peterweissig/proj_audio_home/images/connection_external/1339.jpg

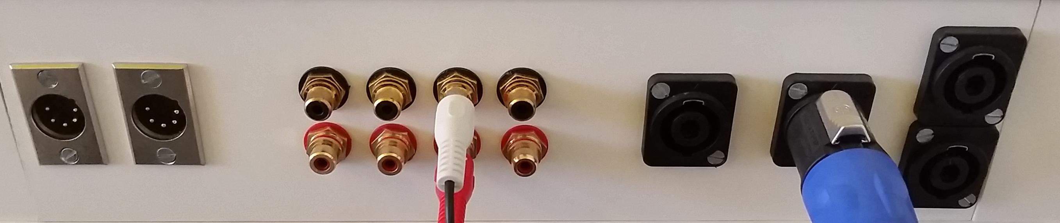
images/connection_external/1339.jpg
