peterweissig/proj_audio_home/README.md

# project_audio_home
Simple audio project for sound system @home
