peterweissig/proj_audio_home/circuits/amplifier/export/images/one_layer_pcb/circuit.png

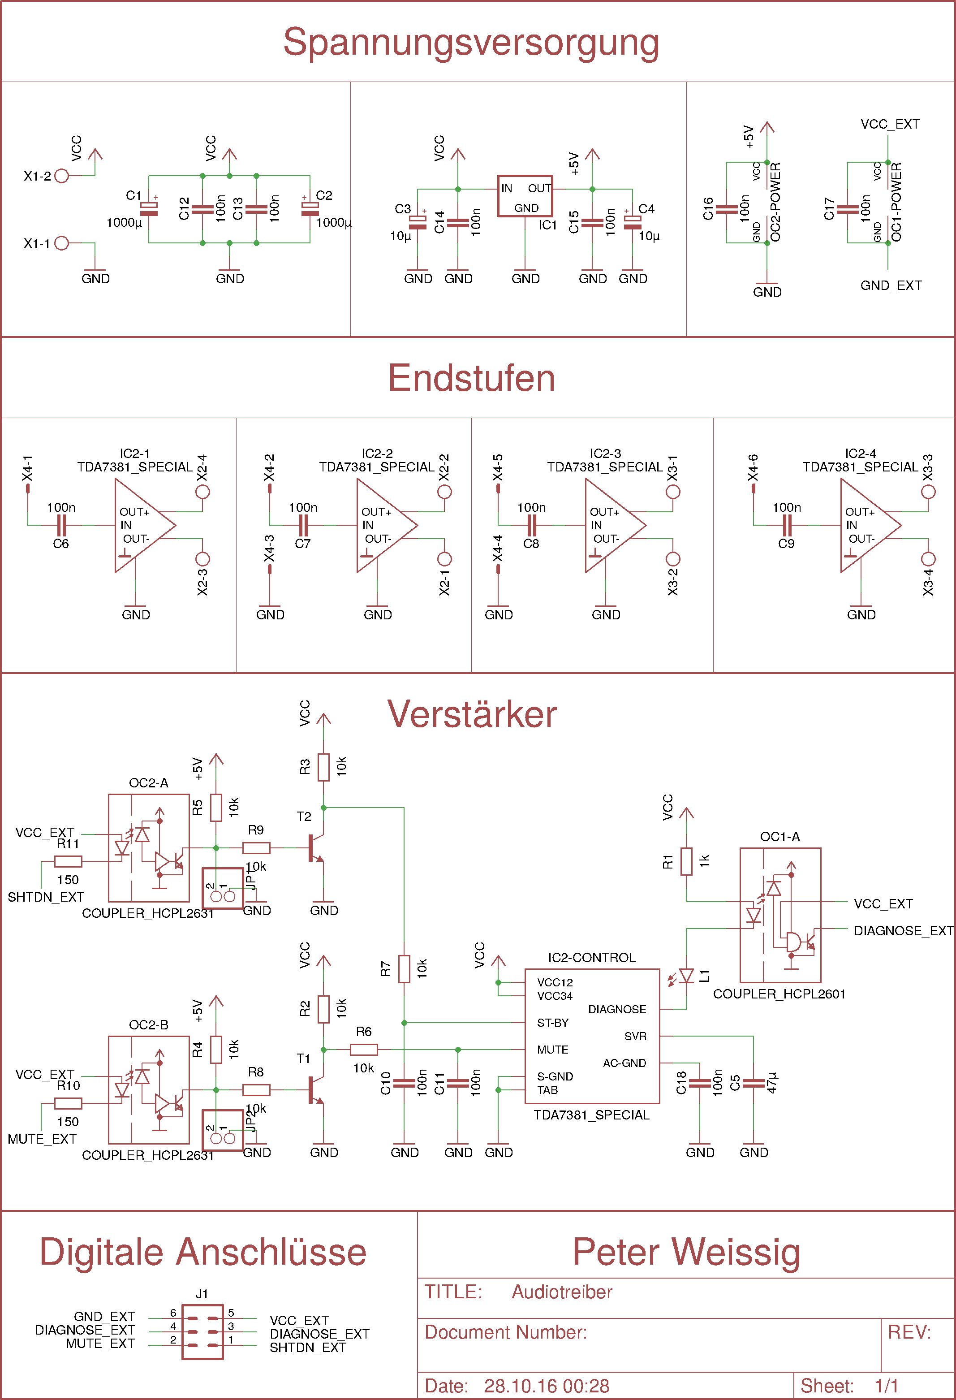
circuits/amplifier/export/images/one_layer_pcb/circuit.png
