peterweissig/proj_audio_home/circuits/amplifier/export/images/one_layer_pcb/layout.png

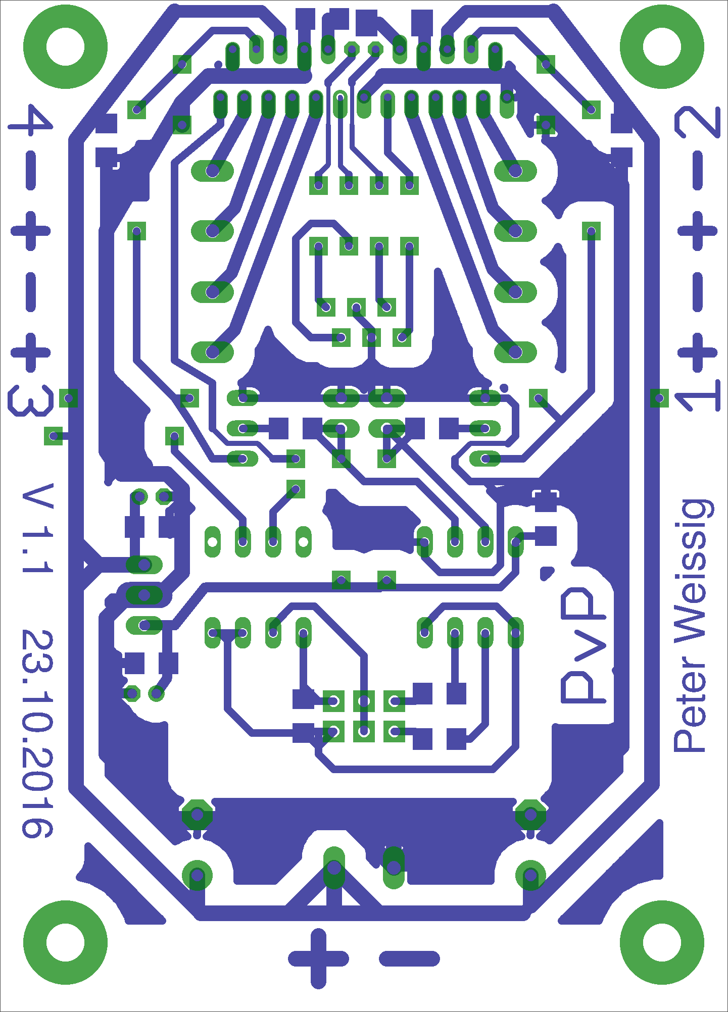
circuits/amplifier/export/images/one_layer_pcb/layout.png
