peterweissig/proj_audio_home/circuits/amplifier/two_layer_pcb/export/images/circuit.png

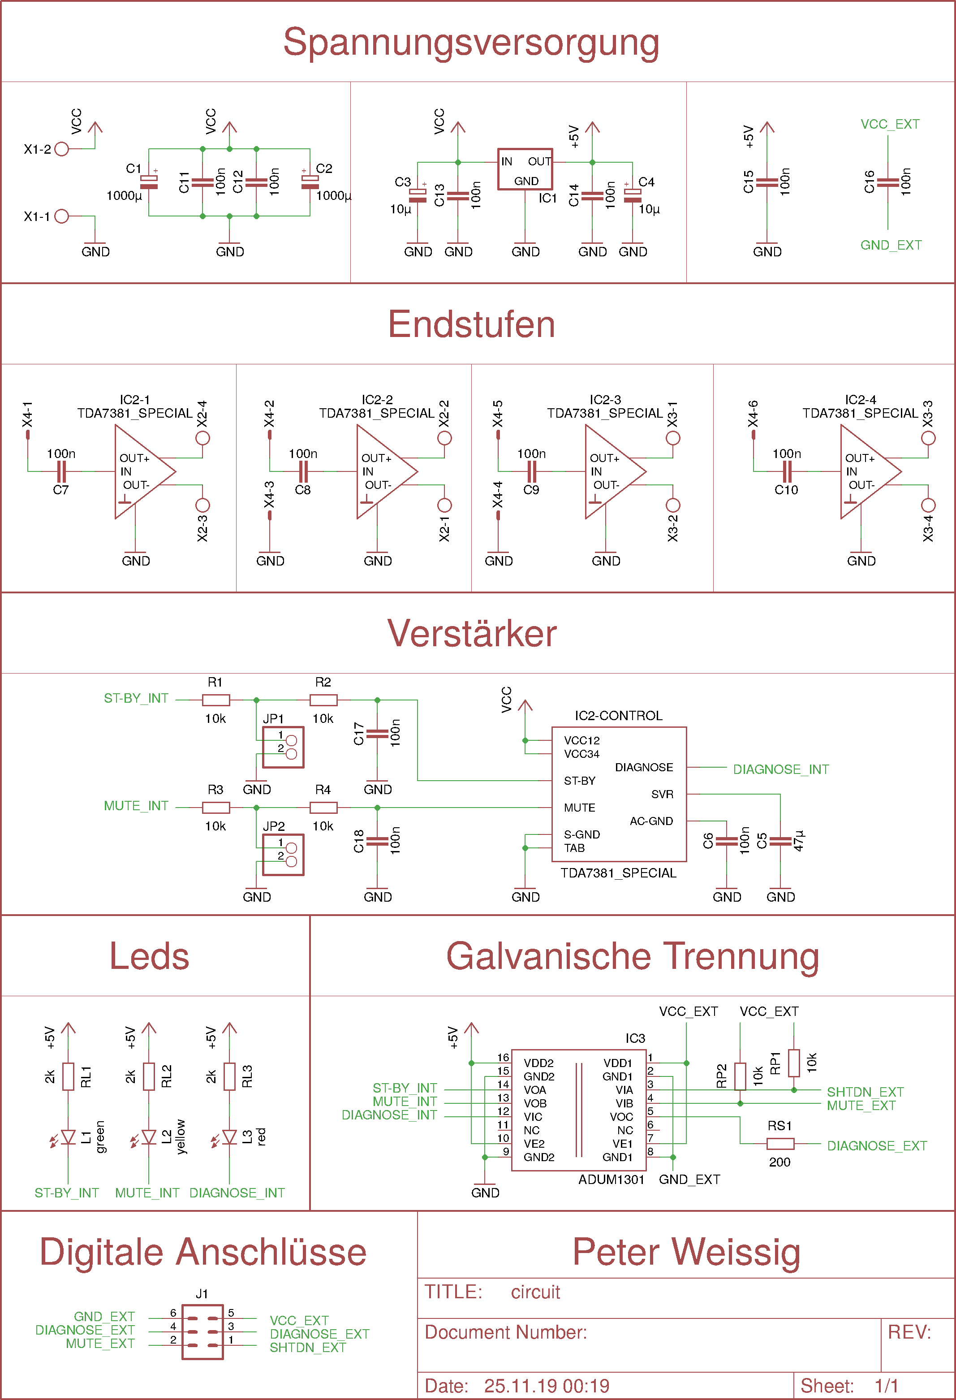
circuits/amplifier/two_layer_pcb/export/images/circuit.png
