peterweissig/proj_audio_home/drawings/connection_external/sketch.png

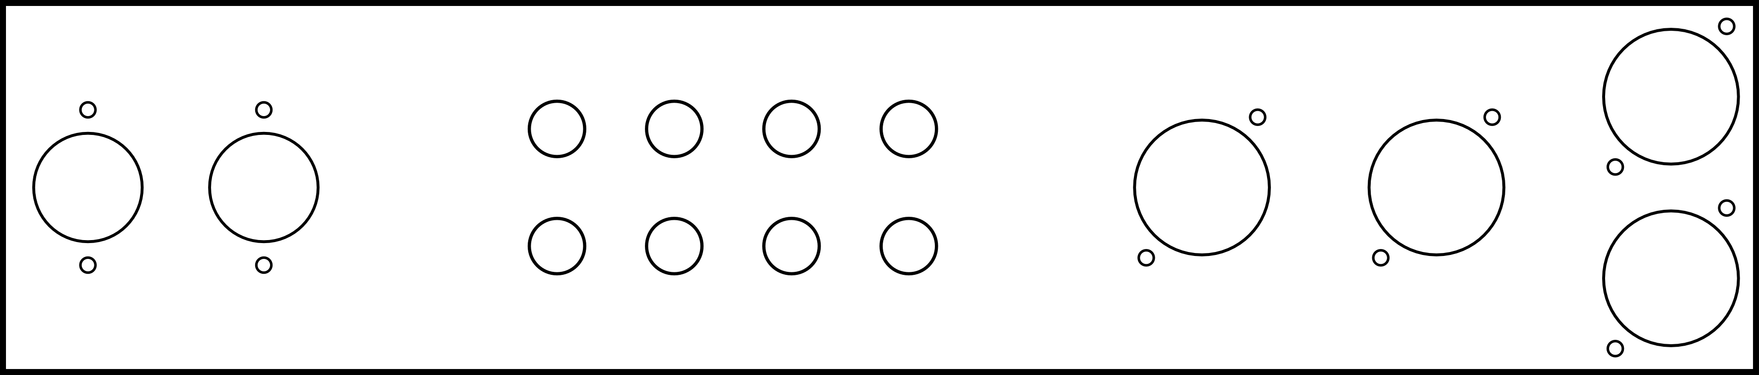
drawings/connection_external/sketch.png
