peterweissig/proj_audio_home/circuits/amplifier/parts/one_layer_pcb/parts.pdf

## Verstärker

Peter Weissig | Seite 1 von 1 | 28.10.2016
C1, C2 | 1000µF; d10; 5mm | RAD FR 1.000/25 | 2 | 0,29 € | 0,58 €
C3, C4 | 10µF; d5; 2,5mm | RAD FR 47/25 | 2 | 0,09 € | 0,18 €
C5 | 47µF; SMD 2312 | TAJ 6032 47/20 | 1 | 0,40 € | 0,40 €
C6, C7, C8, …, C11 | 100nF; 5mm | X7R-5 100N | 6 | 0,05 € | 0,30 €
C12, C13, …, C18 | 100nF; SMD 1206 | X7R-G1206 100N | 7 | 0,04 € | 0,28 €
IC1 | V-Reg; 5V; 1A | LM 2940 CT5 | 1 | 0,63 € | 0,63 €
IC2 | Audioverstärker; 4x; 100 | TDA 7381 | 1 | 3,20 € | 3,20 €
J1 | Wannenstecker 6-polig | | 1 | | 0,00 €
JP1, JP2 | Pinhead_1_2 | | 2 | | 0,00 €
L1 | Led_rot_3mm | | 1 | | 0,00 €
OC1 | Optokoppler; 1x | HCPL 2601 | 1 | 1,25 € | 1,25 €
OC2 | Optokoppler; 2x | HCPL 2631 | 1 | 1,80 € | 1,80 €
R1 | 1k; 10mm | | 1 | | 0,00 €
R2, R3, R4, …, R7 | 10k; 10mm | | 6 | | 0,00 €
R8, R9 | 10k; SMD 1206 | | 2 | | 0,00 €
R10, R11 | 150; SMD 1206 | | 2 | | 0,00 €
T1, T2 | BC548 | | 2 | | 0,00 €
X1 | Schraubanschluss; 2x | AKL 101-02 | 1 | 0,34 € | 0,34 €
X2, X3 | Schraubanschluss; 4x | RND 205-00014 | 2 | 0,25 € | 0,50 €
X4 | Micromatch 6-polig; BuchMM FL 6G | | 1 | 0,36 € | 0,36 €
IC_Sockel 8-polig | GS 8 | 2 | 0,04 € | 0,08 €
Micromatch 6-polig; SteckMM SL 6SK | | 1 | 0,26 € | 0,26 €
Kühlkörper | V 5583E | 1 | 2,30 € | 2,30 €
Sicherungsautomat; 4A | T9-611P 4A | 1 | 1,65 € | 1,65 €

14,11 €
‚
