peterweissig/proj_audio_home/circuits/amplifier/export/images/one_layer_pcb/parts_top.png

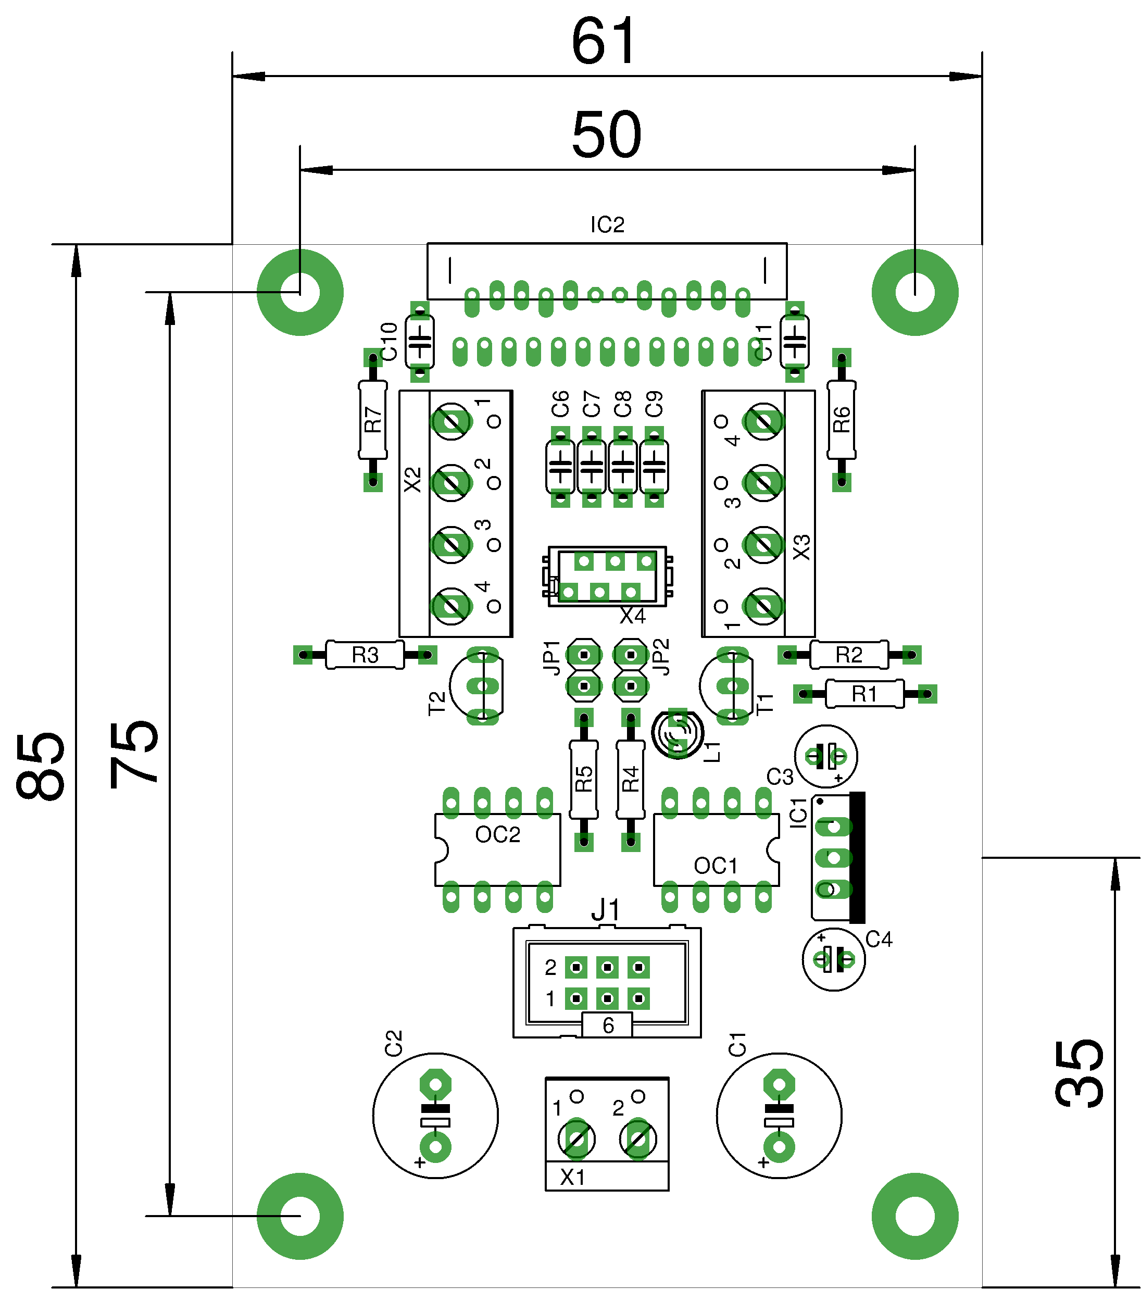
circuits/amplifier/export/images/one_layer_pcb/parts_top.png
