peterweissig/proj_audio_home/circuits/amplifier/two_layer_pcb/export/images/parts_bottom.png

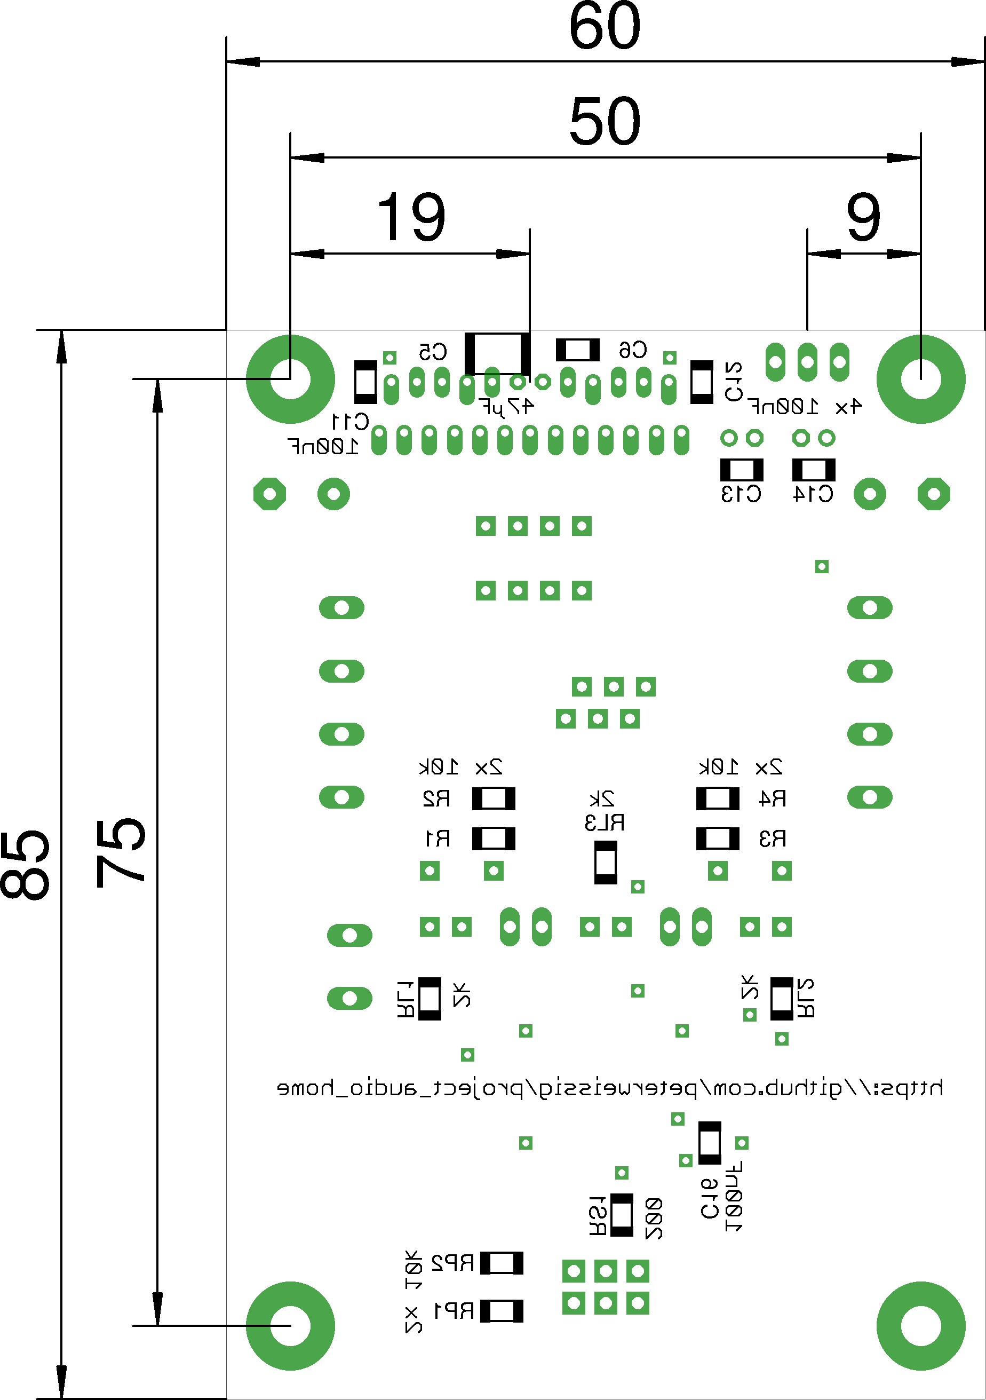
circuits/amplifier/two_layer_pcb/export/images/parts_bottom.png
