peterweissig/proj_audio_home/circuits/amplifier/two_layer_pcb/export/images/circuit.pdf

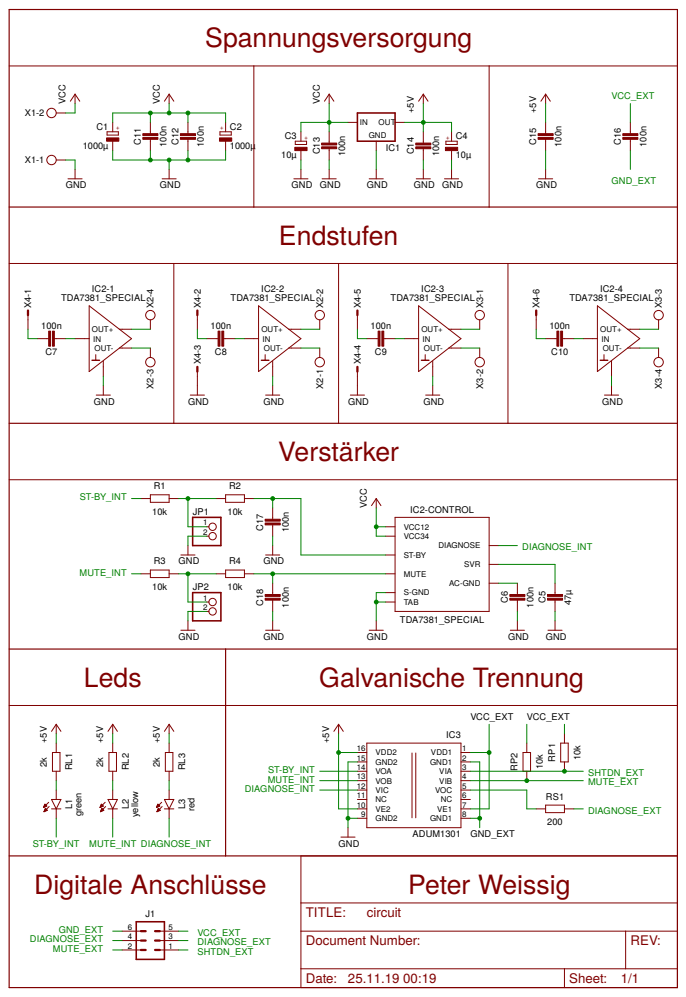
[picture p12: page 1]

Leds | Galvanische Trennung

MUTE_INT DIAGNOSE_INT | VCC_EXT

Document Number: | REV:

Date: 25.11.19 00:19 | Sheet: 1/1
