peterweissig/proj_audio_home/circuits/amplifier/export/images/one_layer_pcb/circuit.pdf

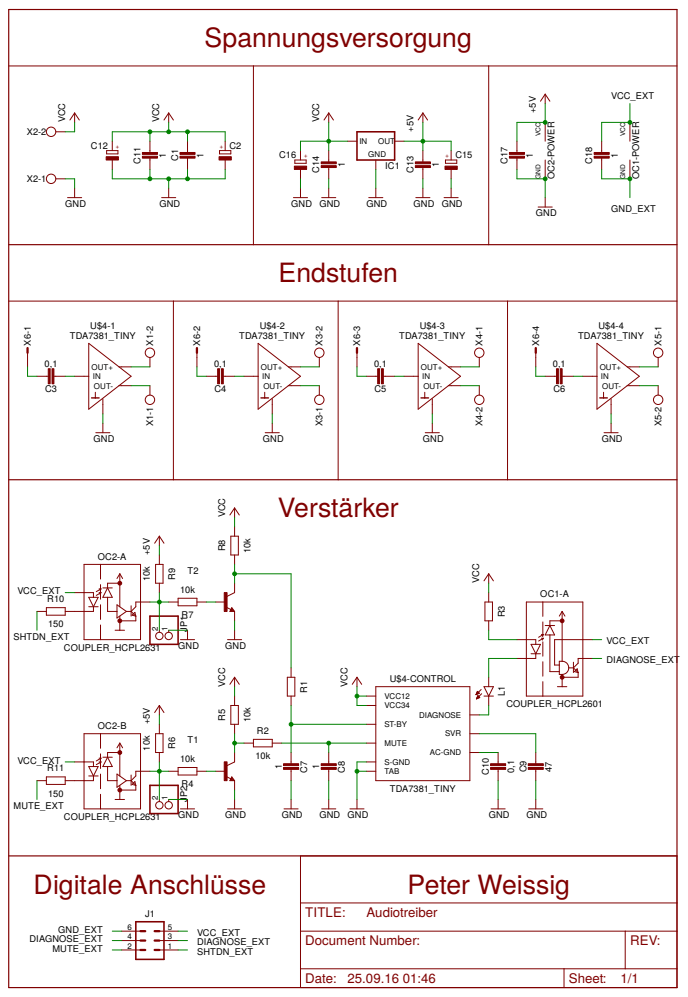
[picture p13: page 1]
