peterweissig/proj_audio_home/circuits/amplifier/two_layer_pcb/circuit/circuit.brd

## EAGLE design circuits/amplifier/two_layer_pcb/circuit/circuit.brd (2019-12-15)

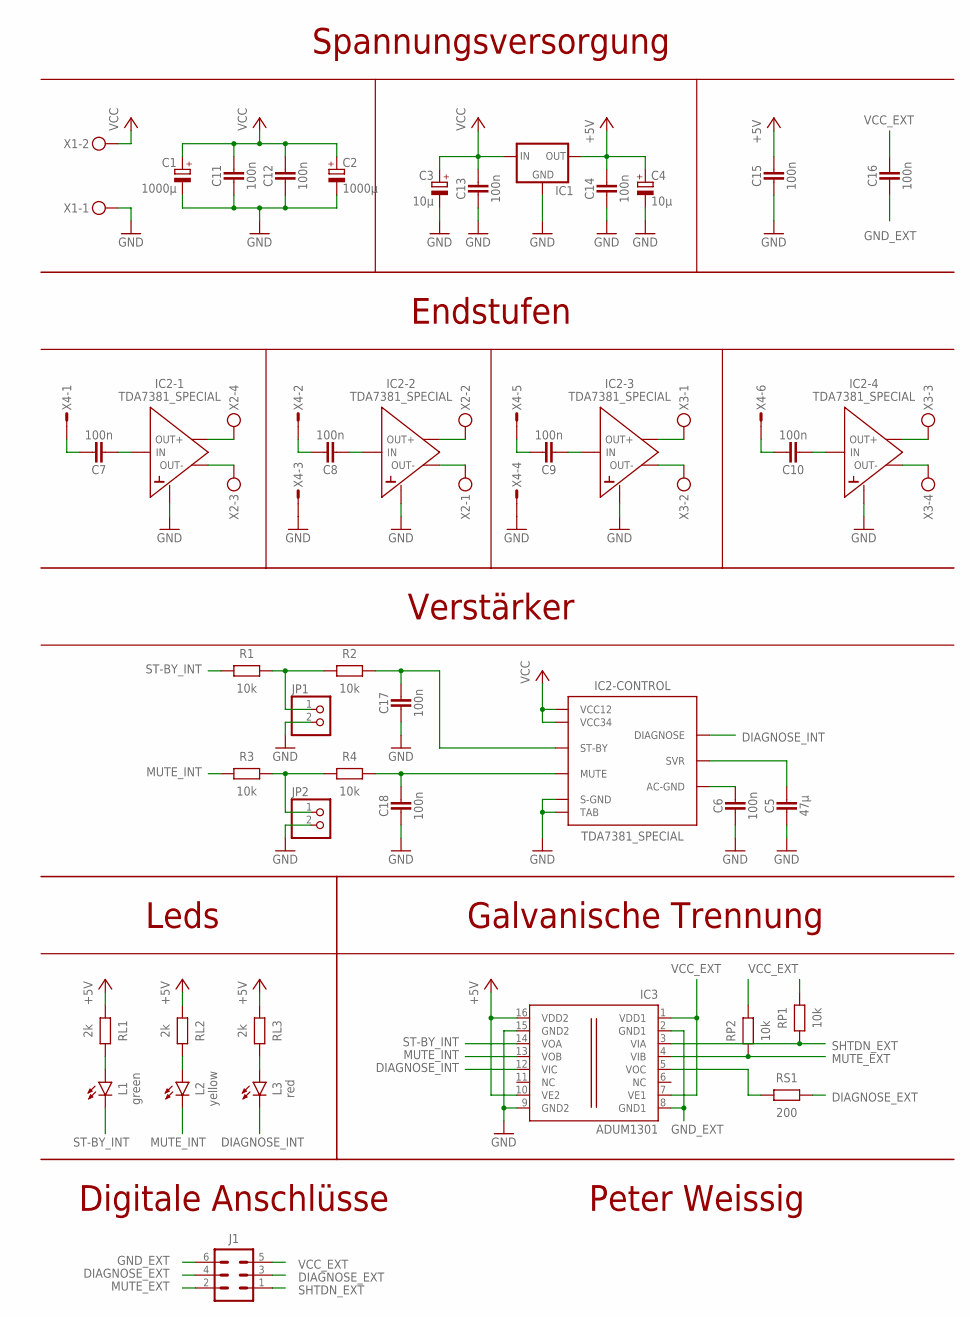
[picture p14: schematic circuit.sch]

Parts:
C1, C2: 1000µ; E5-10,5
C3, C4: 10µ; E2-5
C5: 47µ; SMD_2312S
C6, C11, C12, C13, C14, C15, C16: 100n; SMD_1206
C7, C8, C9, C10, C17, C18: 100n; C_THT_3
IC1: 78XXS
IC2: TDA7381_SPECIAL; IC_FLEXIWATT25_SPECIAL
IC3: ADUM1301; SO-16W
J1: STECKER_WANNE_6
JP1, JP2: PINHD-1X2; 1X02
L1: green; LED_3MM
L2: yellow; LED_3MM
L3: red; LED_3MM
R1, R2, R3, R4: 10k; SMD_1206
RL1, RL2, RL3: 2k; SMD_1206
RP1, RP2: 10k; SMD_1206
RS1: 200; SMD_1206
X1: STECKER_SPG_2
X2, X3: STECKER_SPG_4
X4: STECKER_MICROMATCH_6

Connections:
+5V: C4.+, C14.1, C15.1, IC1.OUT, IC3.10 (VE2), IC3.16 (VDD2), RL1.2, RL2.2, RL3.2
DIAGNOSE_EXT: J1.3, J1.4, RS1.2
DIAGNOSE_INT: IC2.25 (DIAGNOSE), IC3.12 (VIC), L3.K (C)
GND: C1.-, C2.-, C3.-, C4.-, C5.2, C6.2, C11.2, C12.2, C13.2, C14.2, C15.2, C17.1, C18.1, IC1.GND, IC2.1 (TAB), IC2.2 (GND), IC2.8 (GND), IC2.13 (S-GND), IC2.18 (GND), IC2.24 (GND), IC3.9 (GND2), IC3.15 (GND2), JP1.2, JP2.2, X1.1, X4.3, X4.4
GND_EXT: C16.2, IC3.2 (GND1), IC3.8 (GND1), J1.6
MUTE: C18.2, IC2.22 (MUTE), R4.2
MUTE_EXT: IC3.4 (VIB), J1.2, RP2.1
MUTE_INT: IC3.13 (VOB), L2.K (C), R3.1
unnamed: C7.2, IC2.11 (IN)
unnamed: C7.1, X4.1
unnamed: C8.1, X4.2
unnamed: C8.2, IC2.12 (IN)
unnamed: C9.1, X4.5
unnamed: C10.1, X4.6
unnamed: C9.2, IC2.15 (IN)
unnamed: C10.2, IC2.14 (IN)
unnamed: JP1.1, R1.2, R2.1
unnamed: C5.1, IC2.10 (SVR)
unnamed: C6.1, IC2.16 (AC-GND)
unnamed: L3.A, RL3.1
unnamed: L1.A, RL1.1
unnamed: JP2.1, R3.2, R4.1
unnamed: L2.A, RL2.1
unnamed: IC3.5 (VOC), RS1.1
OUT1+: IC2.9 (OUT+), X2.4
OUT1-: IC2.7 (OUT-), X2.3
OUT2+: IC2.5 (OUT+), X2.2
OUT2-: IC2.3 (OUT-), X2.1
OUT3+: IC2.17 (OUT+), X3.1
OUT3-: IC2.19 (OUT-), X3.2
OUT4+: IC2.21 (OUT+), X3.3
OUT4-: IC2.23 (OUT-), X3.4
SHTDN_EXT: IC3.3 (VIA), J1.1, RP1.1
ST-BY: C17.2, IC2.4 (ST-BY), R2.2
ST-BY_INT: IC3.14 (VOA), L1.K (C), R1.1
VCC: C1.+, C2.+, C3.+, C11.1, C12.1, C13.1, IC1.IN, IC2.6 (VCC12), IC2.20 (VCC34), X1.2
VCC_EXT: C16.1, IC3.1 (VDD1), IC3.7 (VE1), J1.5, RP1.2, RP2.2

Notes on the sheet:
Spannungsversorgung
Peter Weissig
Endstufen
Digitale Anschlüsse
Galvanische Trennung
Verstärker
Leds

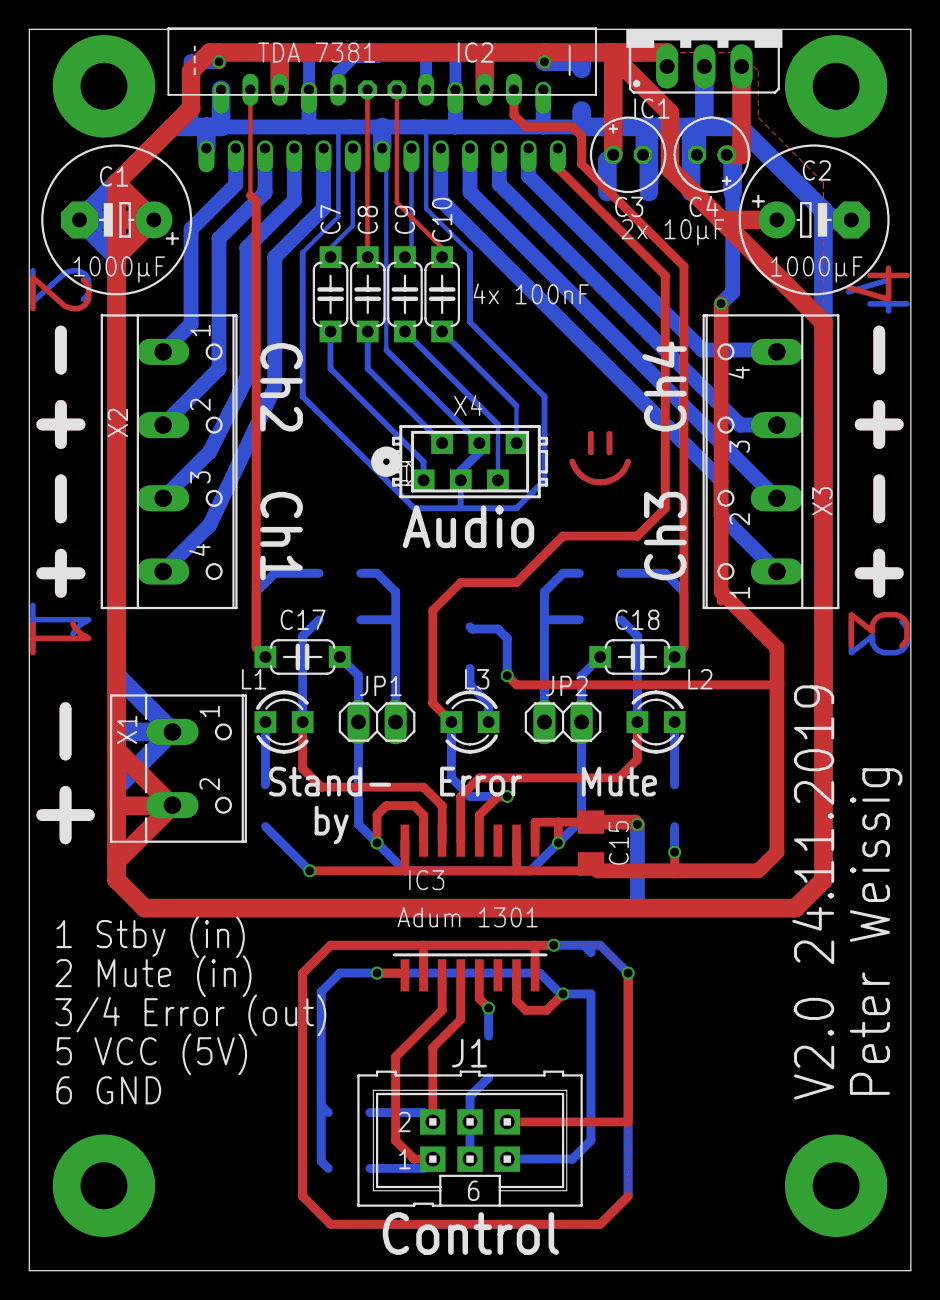
[picture p15: board circuit.brd from above]

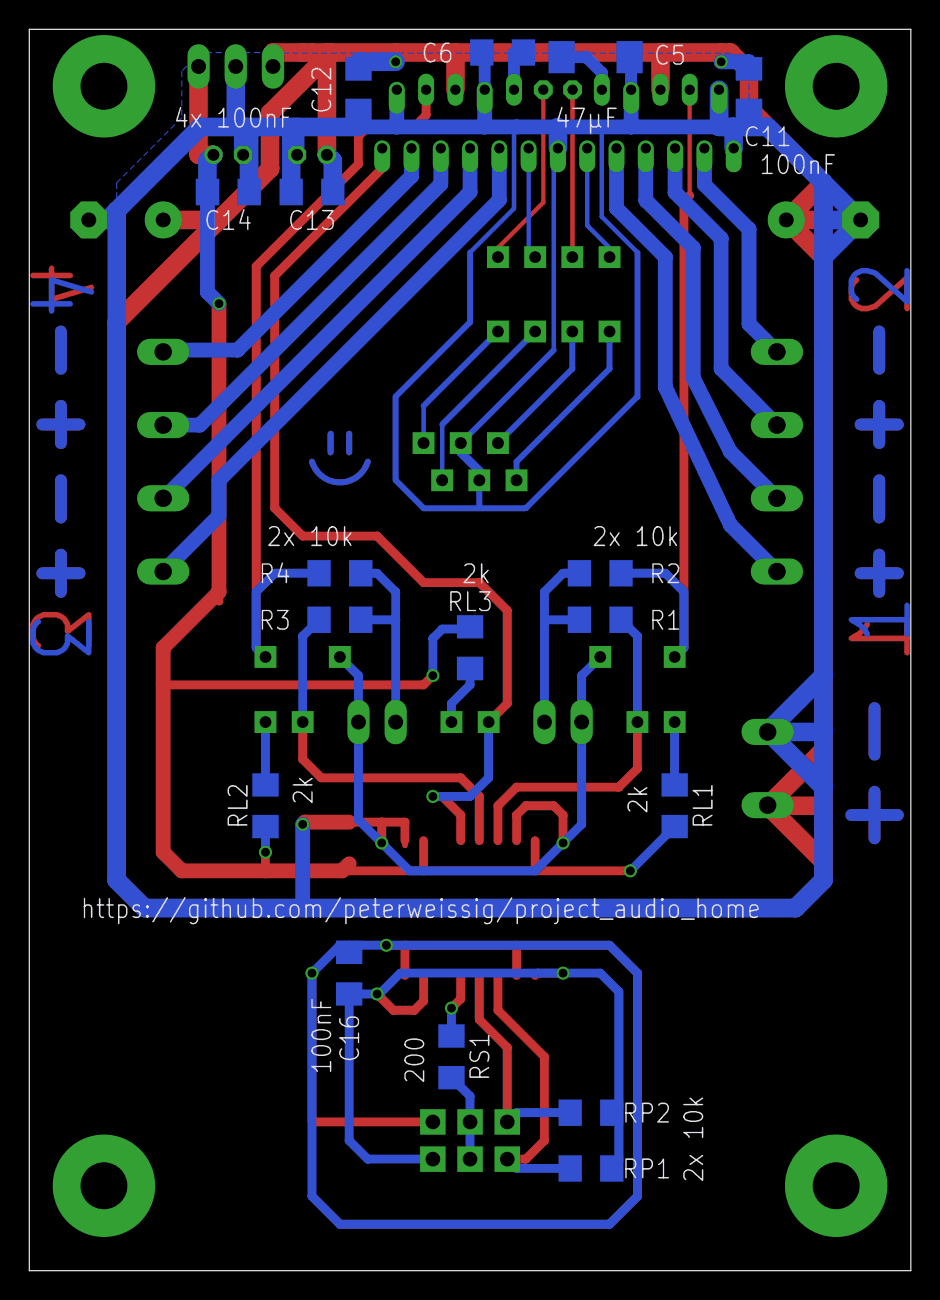
[picture p16: board circuit.brd from below]

Board: 2 copper layers, 60.2 x 84.8 mm, 41 parts (17 on the bottom side), 37 nets.
