peterweissig/proj_audio_home/circuits/amplifier/circuit/one_layer_pcb/circuit.brd

## EAGLE design circuits/amplifier/one_layer_pcb_deprecated/circuit_deprecated/circuit_deprecated.brd (2018-02-25, an earlier design)

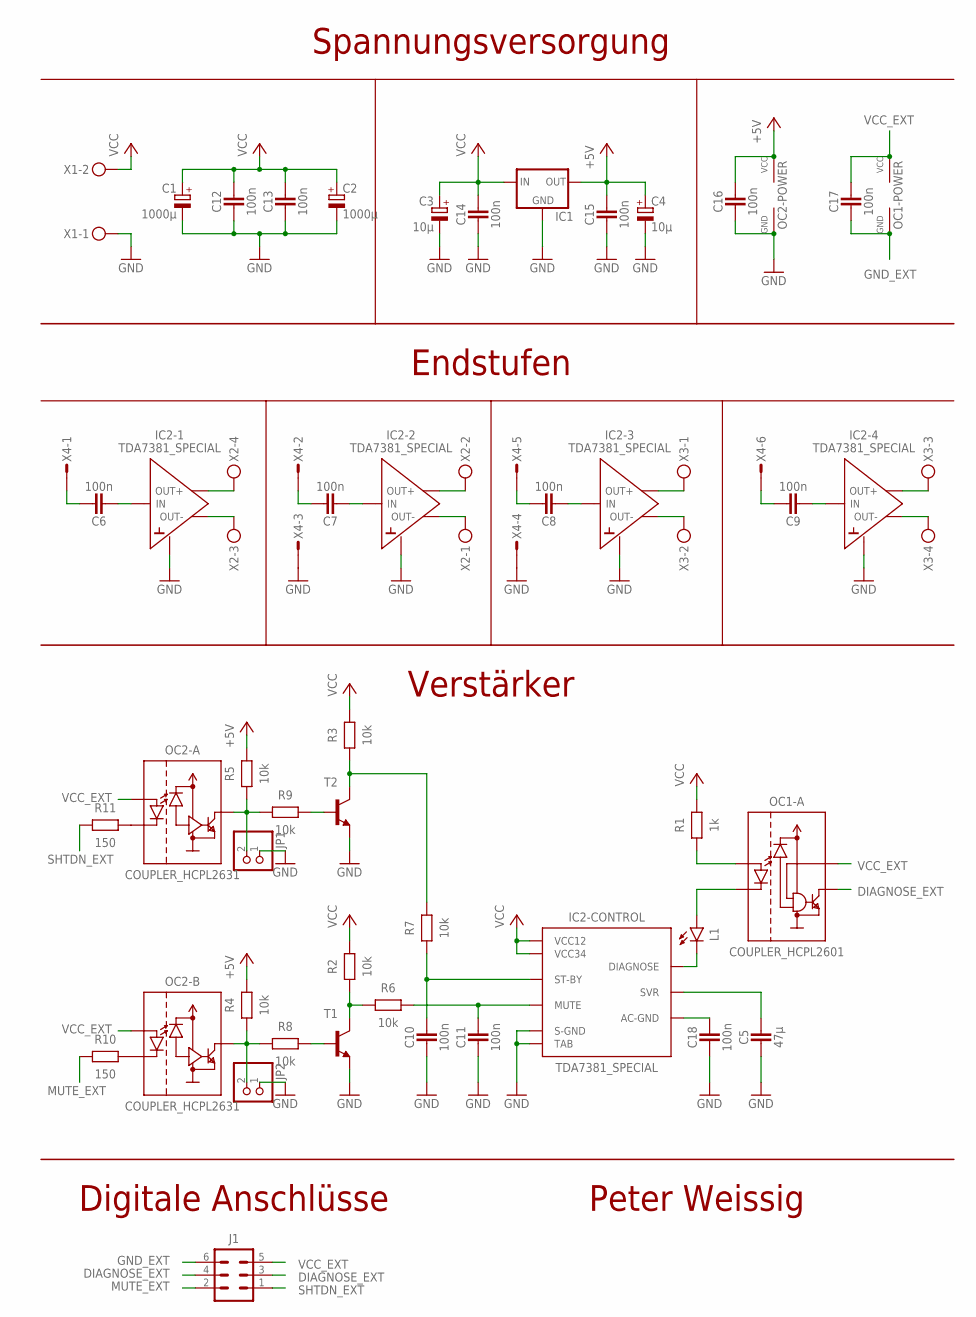
[picture p17: schematic circuit_deprecated.sch]

Parts:
C1, C2: 1000µ; E5-10,5
C3, C4: 10µ; E2-5
C5: 47µ; SMD_2312S
C6, C7, C8, C9, C10, C11: 100n; C_THT_3
C12, C13, C14, C15, C16, C17, C18: 100n; SMD_1206
IC1: 78XXS
IC2: TDA7381_SPECIAL; IC_FLEXIWATT25_SPECIAL
J1: STECKER_WANNE_6
JP1, JP2: PINHD-1X2; 1X02
L1: LED-3MM; LED_3MM
OC1: COUPLER_HCPL2601; IC_DIL08
OC2: COUPLER_HCPL2631; IC_DIL08
R1: 1k; R_THT_4
R2, R3, R4, R5, R6, R7: 10k; R_THT_4
R8, R9: 10k; SMD_1206
R10, R11: 150; SMD_1206
T1, T2: BC548-NPN-TO92-CBE; TO92-CBE
X1: STECKER_SPG_2
X2, X3: STECKER_SPG_4
X4: STECKER_MICROMATCH_6

Connections:
+5V: C4.+, C15.1, C16.1, IC1.OUT, OC2.8 (VCC), R4.2, R5.2
DIAGNOSE_EXT: J1.3, J1.4, OC1.6 (O)
GND: C1.-, C2.-, C3.-, C4.-, C5.2, C10.1, C11.1, C12.2, C13.2, C14.2, C15.2, C16.2, C18.2, IC1.GND, IC2.1 (TAB), IC2.2 (GND), IC2.8 (GND), IC2.13 (S-GND), IC2.18 (GND), IC2.24 (GND), JP1.1, JP2.1, OC2.5 (GND), T1.E, T2.E, X1.1, X4.3, X4.4
GND_EXT: C17.2, J1.6, OC1.5 (GND)
MUTE_EXT: J1.2, R10.2
unnamed: C6.2, IC2.11 (IN)
unnamed: C6.1, X4.1
unnamed: C7.1, X4.2
unnamed: C7.2, IC2.12 (IN)
unnamed: C8.1, X4.5
unnamed: C9.1, X4.6
unnamed: C8.2, IC2.15 (IN)
unnamed: C9.2, IC2.14 (IN)
unnamed: C10.2, IC2.4 (ST-BY), R7.1
unnamed: C11.2, IC2.22 (MUTE), R6.1
unnamed: C5.1, IC2.10 (SVR)
unnamed: C18.1, IC2.16 (AC-GND)
unnamed: IC2.25 (DIAGNOSE), L1.K (C)
unnamed: L1.A, OC1.3 (I_K)
unnamed: R2.2, R6.2, T1.C
unnamed: JP2.2, OC2.6 (O), R4.1, R8.1
unnamed: R8.2, T1.B
unnamed: OC1.2 (I_A), R1.1
unnamed: R3.2, R7.2, T2.C
unnamed: JP1.2, OC2.7 (O), R5.1, R9.1
unnamed: R9.2, T2.B
unnamed: OC2.2 (I_K), R11.1
unnamed: OC2.3 (I_K), R10.1
OUT1+: IC2.9 (OUT+), X2.4
OUT1-: IC2.7 (OUT-), X2.3
OUT2+: IC2.5 (OUT+), X2.2
OUT2-: IC2.3 (OUT-), X2.1
OUT3+: IC2.17 (OUT+), X3.1
OUT3-: IC2.19 (OUT-), X3.2
OUT4+: IC2.21 (OUT+), X3.3
OUT4-: IC2.23 (OUT-), X3.4
SHTDN_EXT: J1.1, R11.2
VCC: C1.+, C2.+, C3.+, C12.1, C13.1, C14.1, IC1.IN, IC2.6 (VCC12), IC2.20 (VCC34), R1.2, R2.1, R3.1, X1.2
VCC_EXT: C17.1, J1.5, OC1.7 (I_EN), OC1.8 (VCC), OC2.1 (I_A), OC2.4 (I_A)

Notes on the sheet:
Spannungsversorgung
Peter Weissig
Verstärker
Endstufen
Digitale Anschlüsse

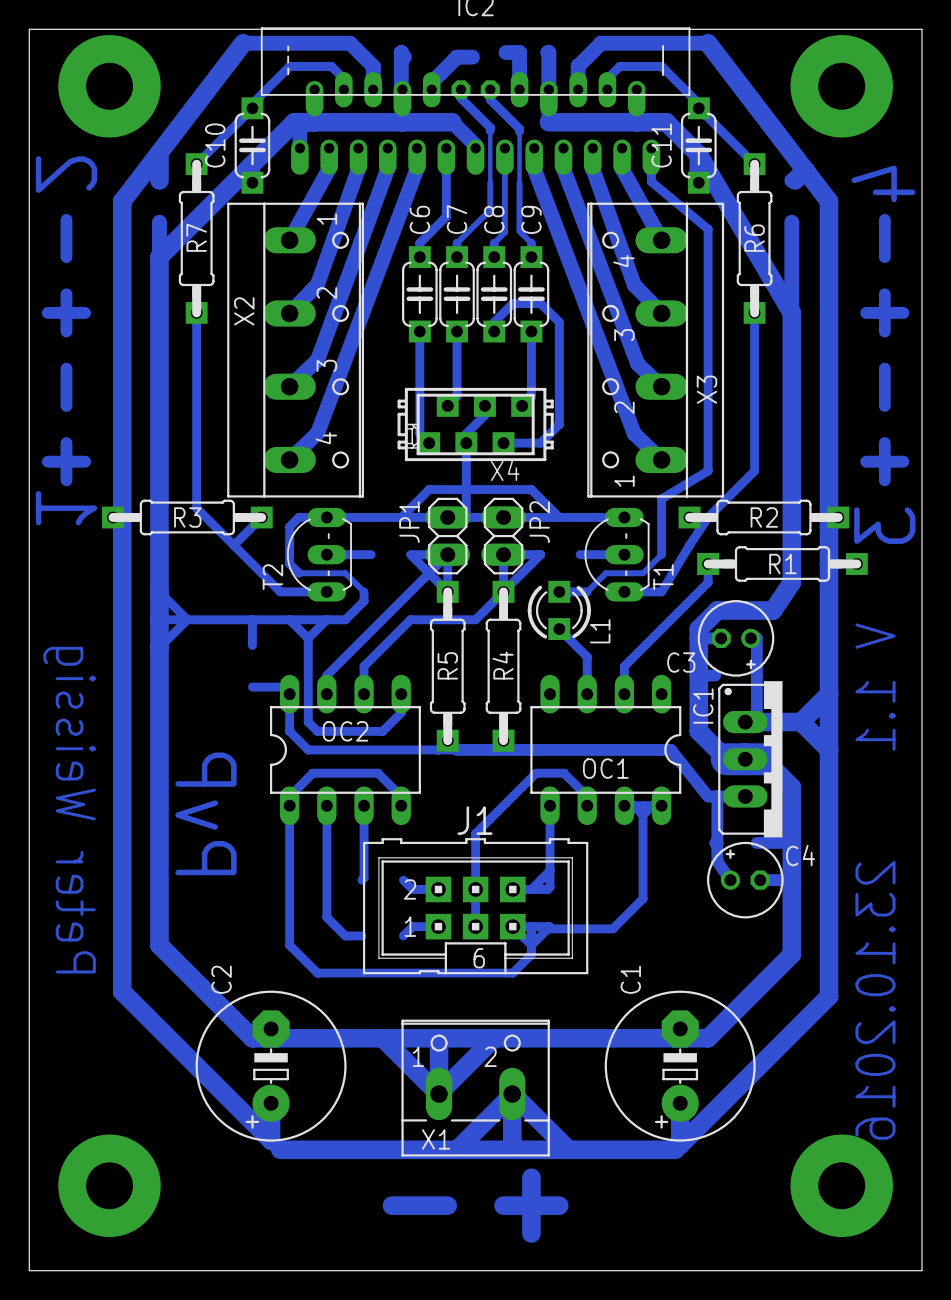
[picture p18: board circuit_deprecated.brd from above]

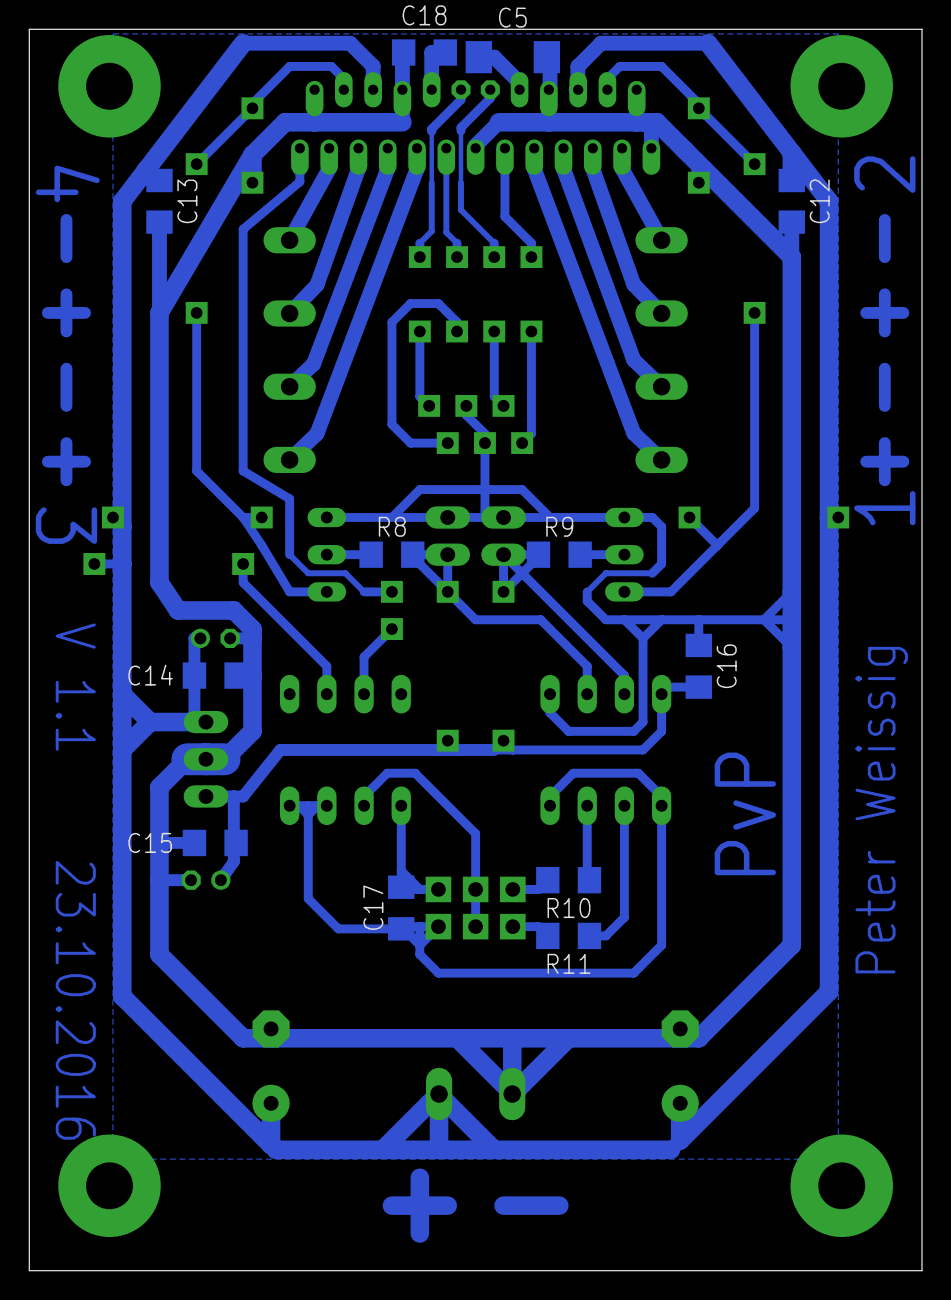
[picture p19: board circuit_deprecated.brd from below]

Board: 2 copper layers, 61.0 x 84.8 mm, 43 parts (12 on the bottom side), 39 nets.
