peterweissig/proj_audio_home/(commit log)

2019-11-24 moved files of old one-sided pcb (audio-driver)
    [circuit_deprecated.brd, circuit_deprecated.sch, parts_deprecated.ods]
2019-11-24 added new two-sided version of audio-driver + exported images + exported elecrow-data + todo: part list
    [circuit.GBL, circuit.GBO, circuit.GBP, circuit.GBS, circuit.GTL, circuit.GTO, circuit.GTP, circuit.GTS]
2019-12-15 switched layer of some visible marks (so they are printed on the circuit boards)
    [circuit.brd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]
